ns96/TFT_R2R_Remote/img/X10R_1.jpg

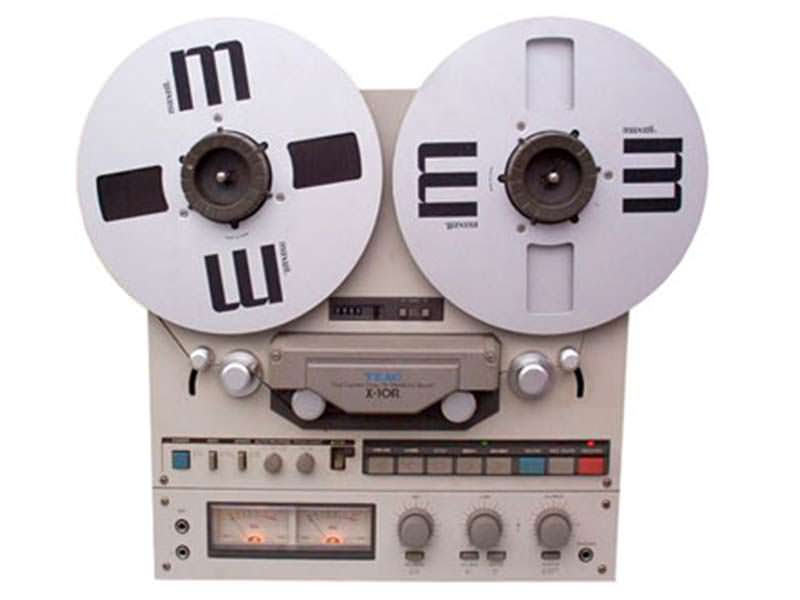
img/X10R_1.jpg
