ns96/TFT_R2R_Remote/TFT_R2R_Remote_Wiring.pdf

# R2R Bluetooth Remote Using

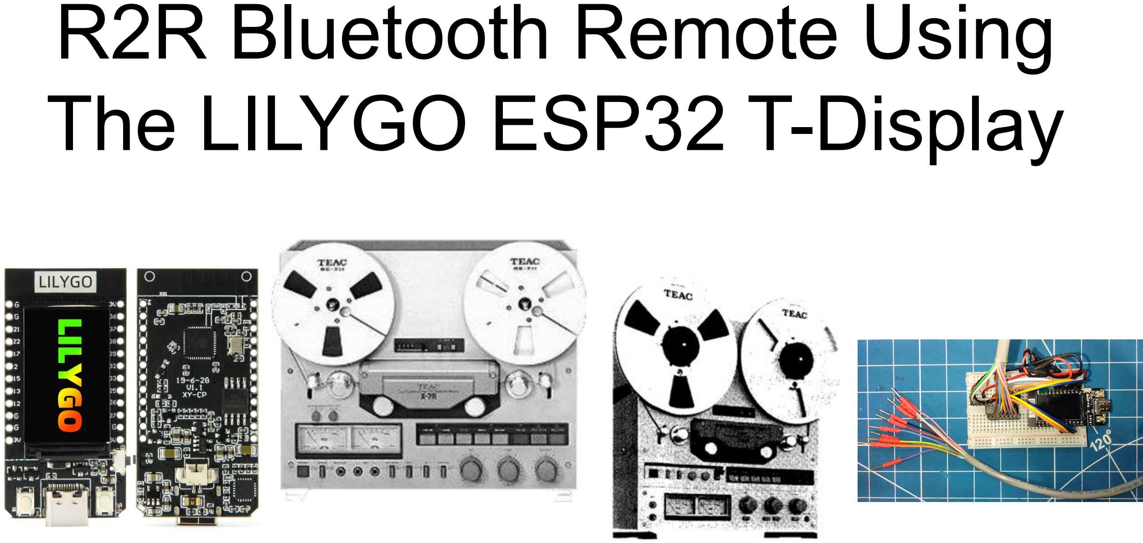
[picture p9: page 1]

# The LILYGO ESP32 T-Display

## Description

This projects make use of the | LilyGo TTGO T-Display (http://www.lilygo.cn/prod_view.aspx?Id=1126) | for a Bluetooth based
remote control for vintage Teac X10R/X7R Reel to Reel (R2R) tape decks. Using custom firmware it places the TTGO board into classic Bluetooth mode allowing any PC/Mac computer to send commands to the R2R decks over a serial connection. It also works with Android devices as well. In many ways the TTGO board is perfect for such remotes because it’s easy to code for using the Arduino IDE, and the OLED display makes for easy debugging. As a matter of fact, the most difficult part about fabricating the remotes was making the connection cable to the R2R decks since the make use of a connection (12 pin WAKA) that’s no longer in production.

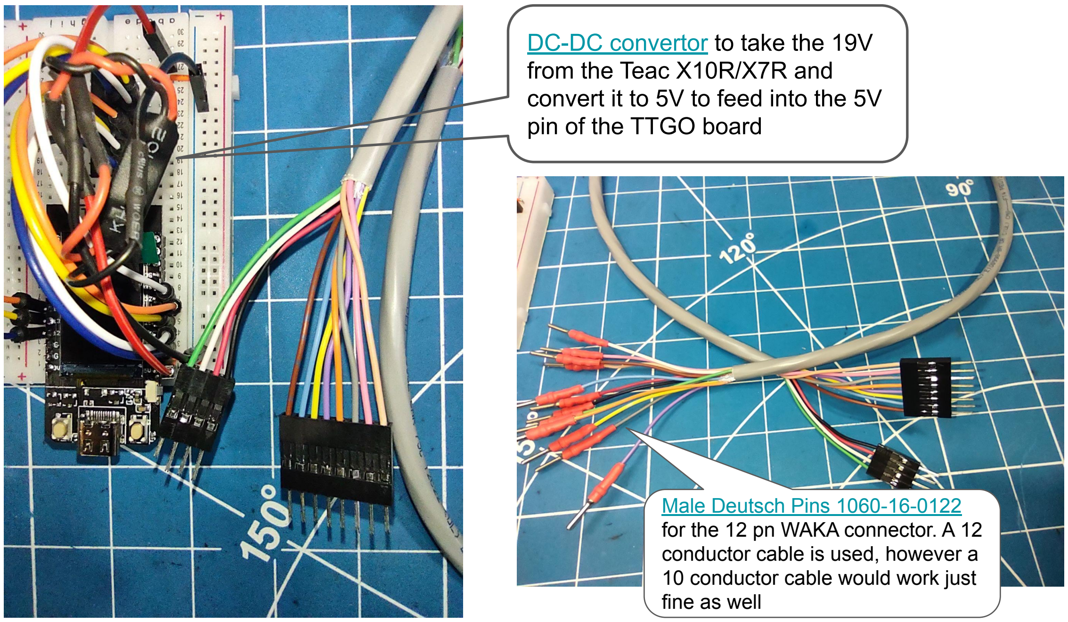
[picture p10: page 3]

DC-DC convertor (https://www.amazon.com/dp/B076P4C42B) to take the 19V from the Teac X10R/X7R and convert it to 5V to feed into the 5V pin of the TTGO board

Male Deutsch Pins 1060-16-0122 (https://www.amazon.com/gp/product/B09F2KY485) for the 12 pn WAKA connector. A 12 conductor cable is used, however a 10 conductor cable would work just fine as well

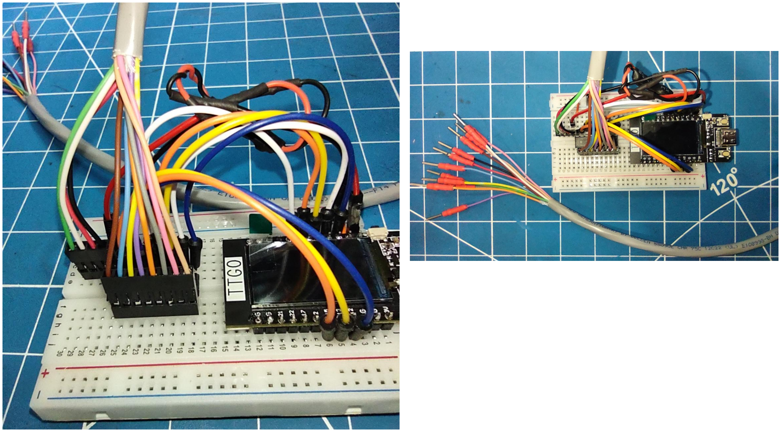
[picture p11: page 4]

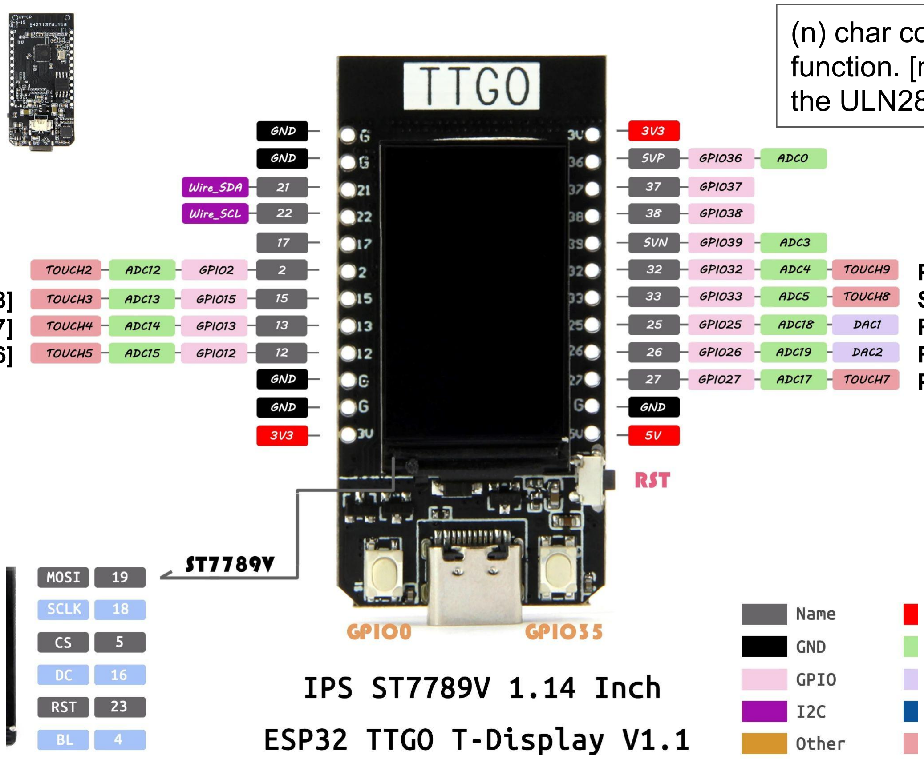
[picture p12: figure]

PAUSE (4) | [5]
STOP (0) | [4]
REV (2) | [3]
FF (3) | [2]
PLAY (1) | [1]
REV_PLAY (6) | [8]
REC_MUTE (7) | [7]
REC (5) | [6]
(n) char command for that
function. [n] the pin # on the ULN2803 IC chip

PLAY | [27]
FF | [26]
REV | [25]
STOP | [33]
PAUSE | [32]
REC | [12]

REC_MUTE [13]

REV_PLAY [15]

TTGO/R2R GND

Indicates the pin # on the TTGO board

Beige | [1]
Pink | [2]
Gray | [3]
Orange | [4]
Purple | [5]
Yellow | [6]
Light Blue | [7]
Brown | [9]

Indicates the pin # on the 12 pin R2R WAKA connector

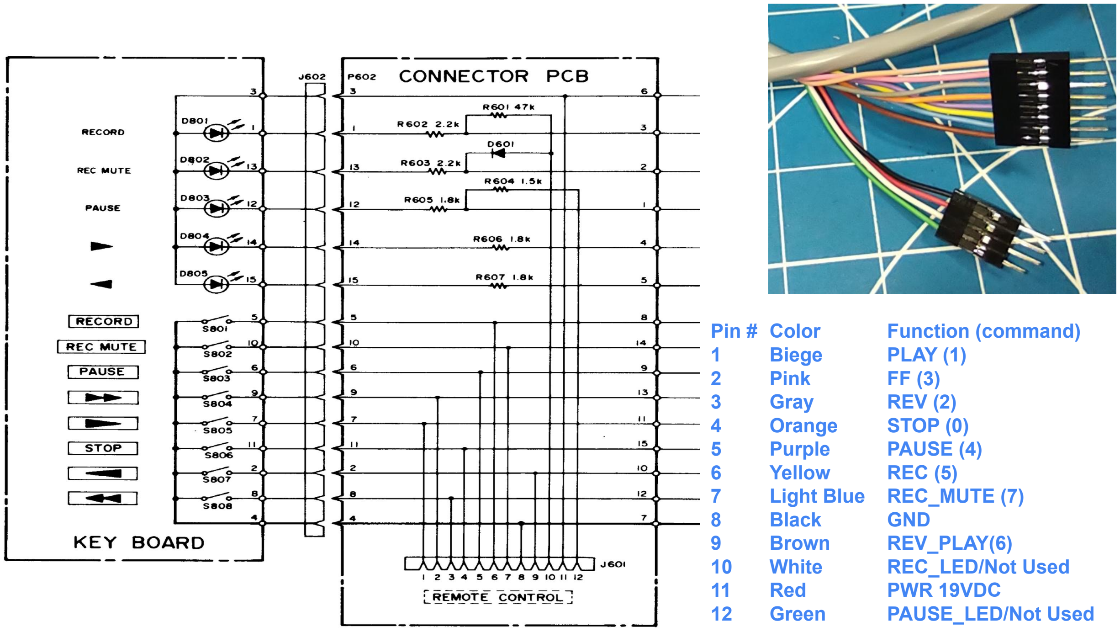
[picture p13: page 7]

Pin # Color | Function (command)
1 | Biege | PLAY (1)
2 | Pink | FF (3)
3 | Gray | REV (2)
4 | Orange | STOP (0)
5 | Purple | PAUSE (4)
6 | Yellow | REC (5)

### 7 Light Blue REC_MUTE (7)

8 | Black | GND
9 | Brown | REV_PLAY(6)
10 | White | REC_LED/Not Used
11 | Red | PWR 19VDC
12 | Green | PAUSE_LED/Not Used
